WCP52/input_frontend/pcb/renders/render_2l_small.png

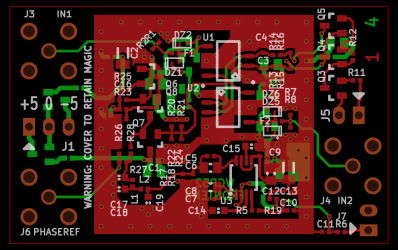
pcb/renders/render_2l_small.png
