WCP52/input_frontend/pcb/renders/render_lyr1_small.png

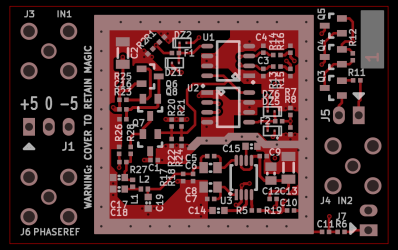
pcb/renders/render_lyr1_small.png
