WCP52/input_frontend/README.md

input_frontend
==============

Gain/Phase analyzer input frontend
