WCP52/input_frontend/pcb/renders/page_Buffer_Filter-Buffer_Filter.png

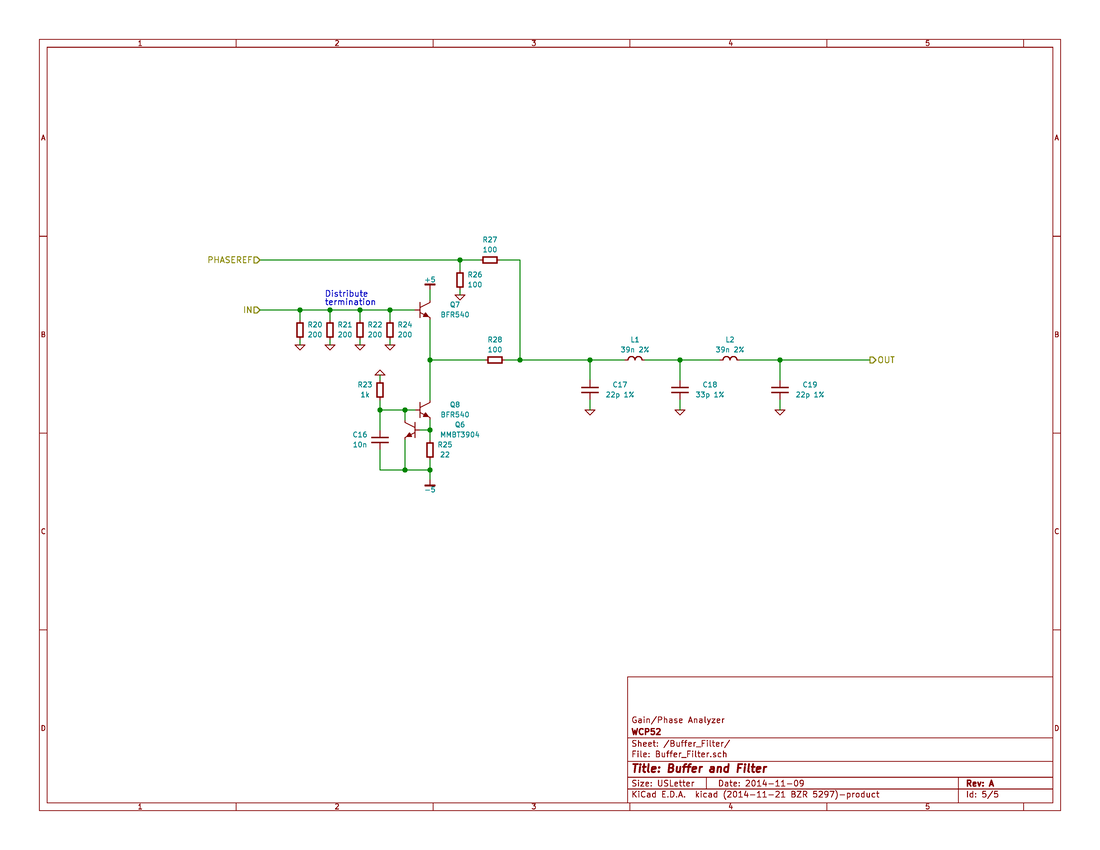
pcb/renders/page_Buffer_Filter-Buffer_Filter.png
