WCP52/input_frontend/pcb/renders/page_Detector-Detector.png

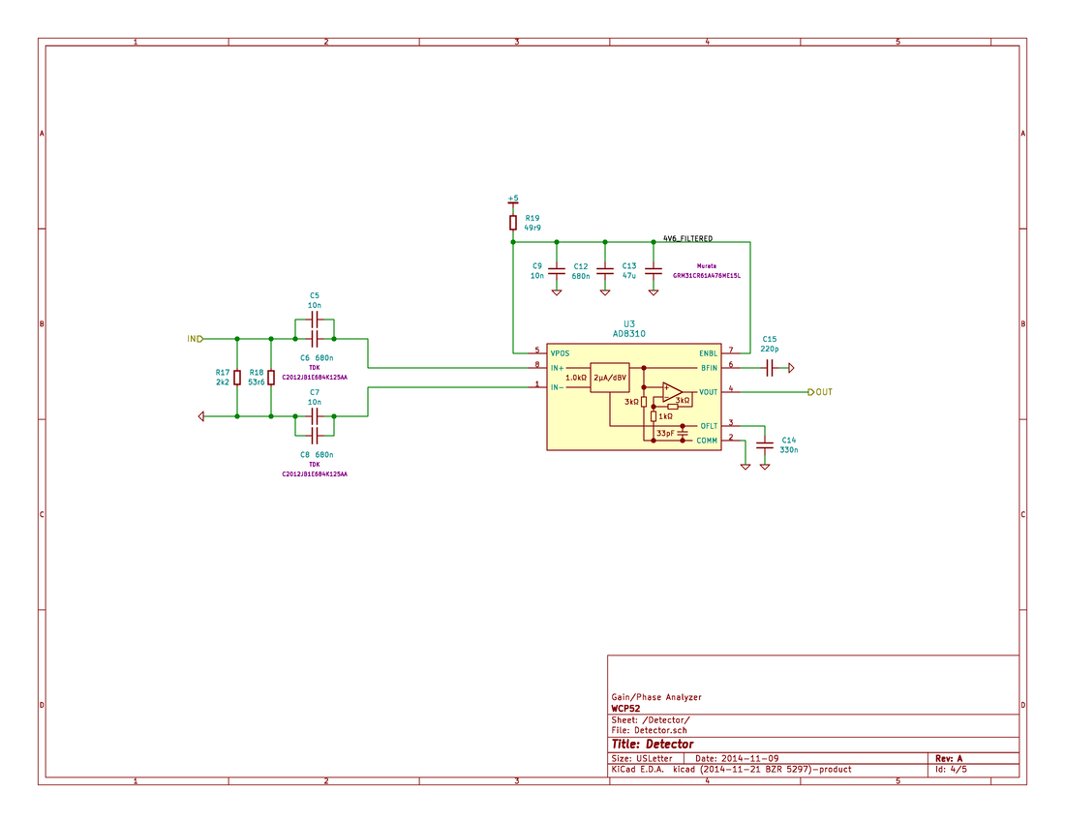
pcb/renders/page_Detector-Detector.png
