WCP52/input_frontend/pcb/renders/page_Protection-Protection.png

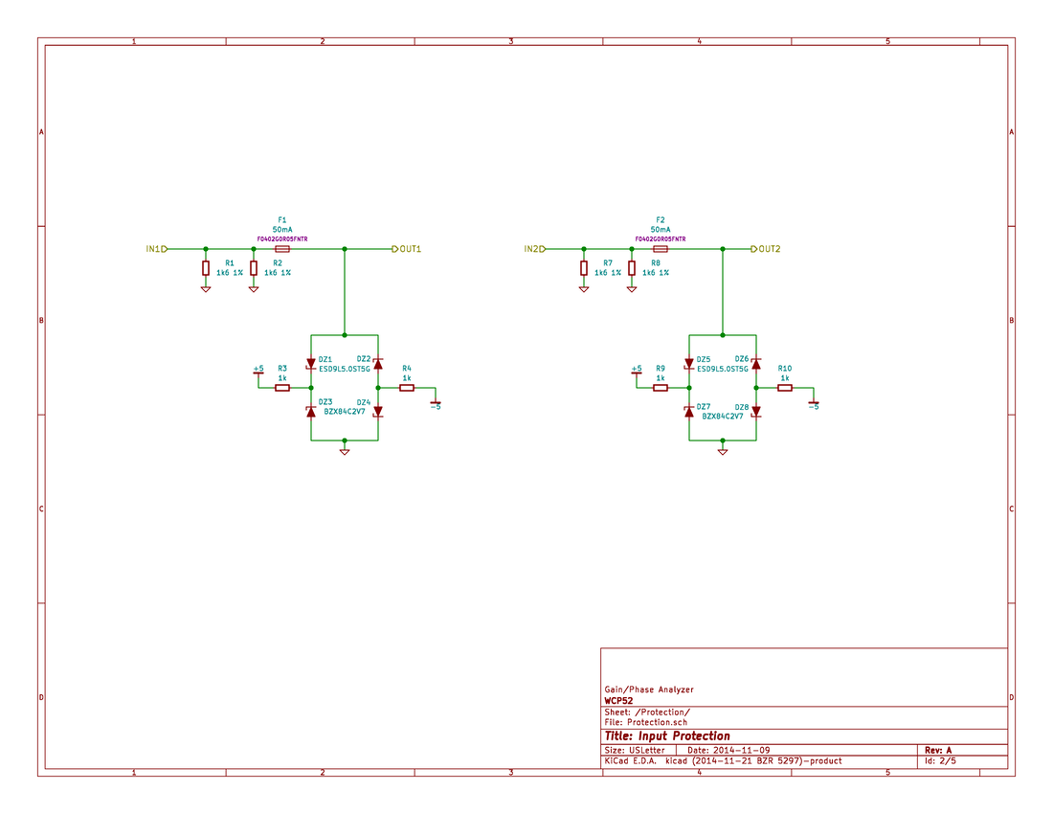
pcb/renders/page_Protection-Protection.png
