WCP52/input_frontend/pcb/renders/page_Switching-Switching.png

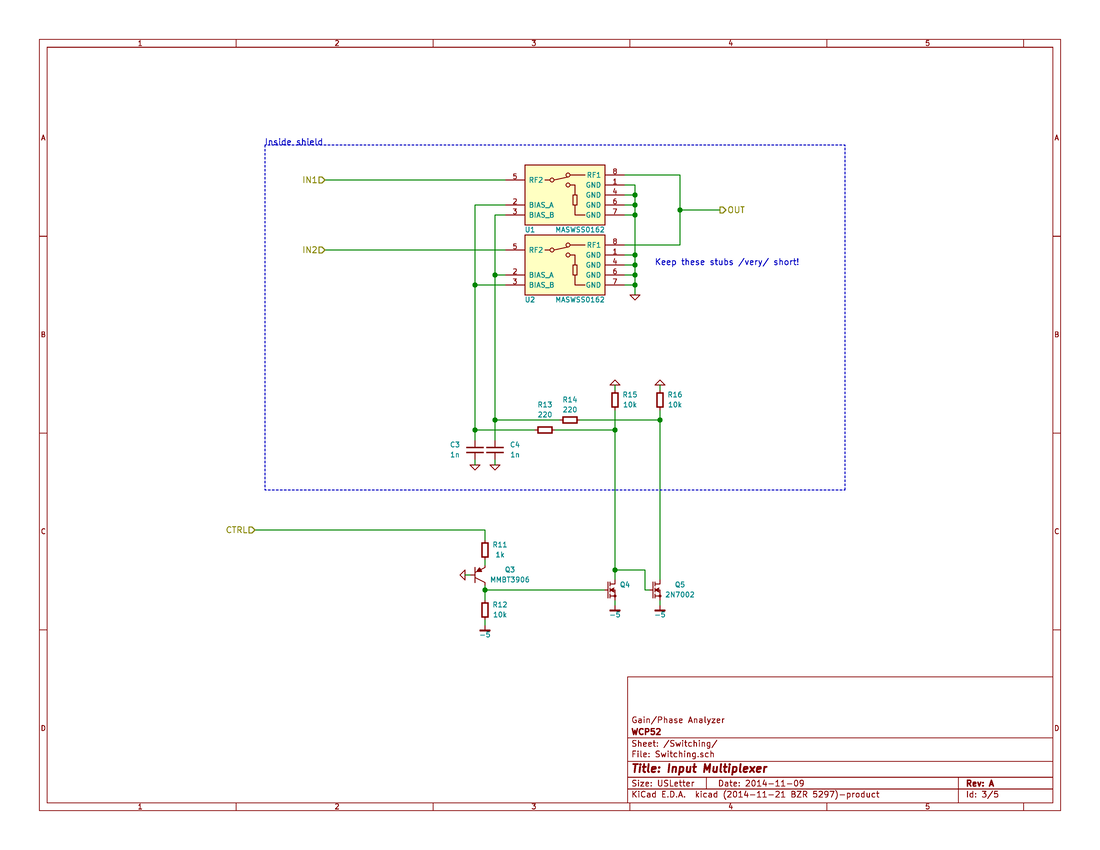
pcb/renders/page_Switching-Switching.png
