WCP52/input_frontend/pcb/renders/page_wcp52-input.png

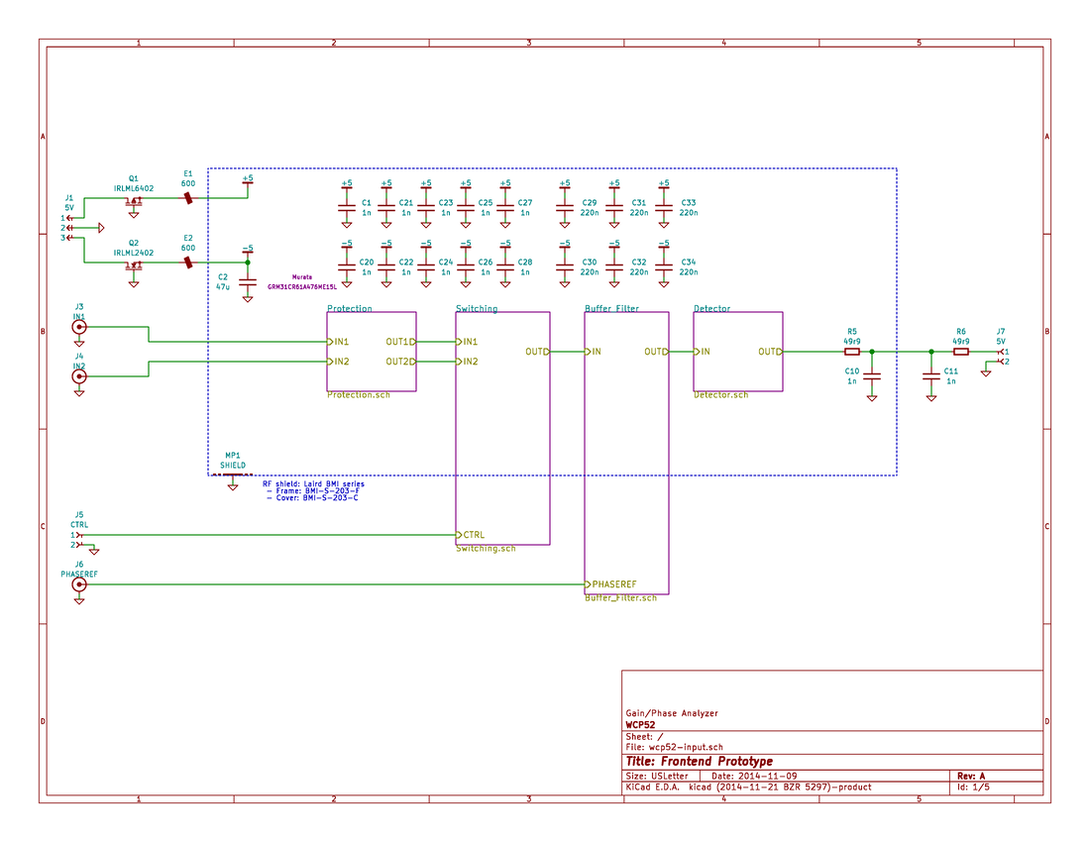
pcb/renders/page_wcp52-input.png
