WCP52/input_frontend/pcb/renders/render_3d_small.png

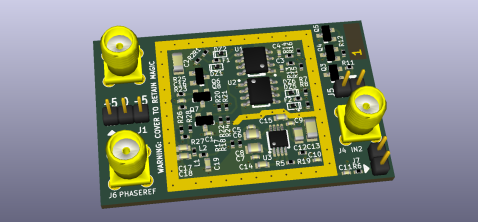
pcb/renders/render_3d_small.png
