WCP52/input_frontend/pcb/renders/render_lyr2.png

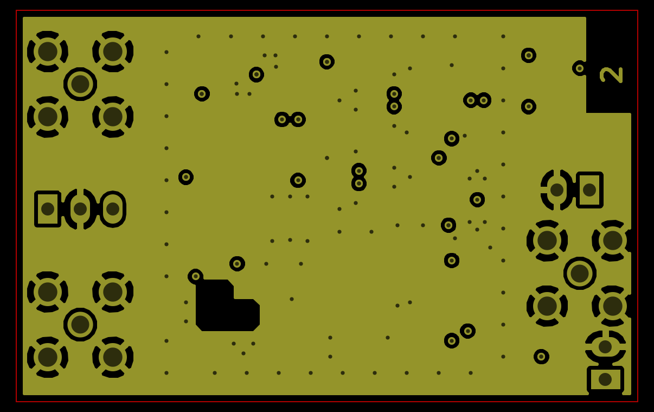
pcb/renders/render_lyr2.png
