WCP52/input_frontend/pcb/renders/render_lyr3.png

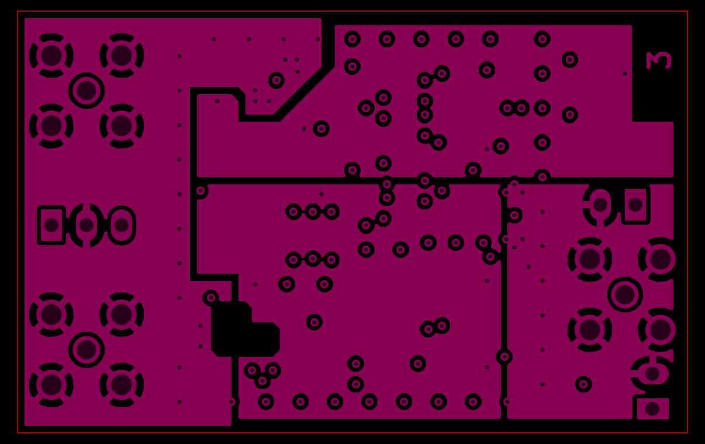
pcb/renders/render_lyr3.png
