WCP52/input_frontend/pcb/renders/render_lyr4.png

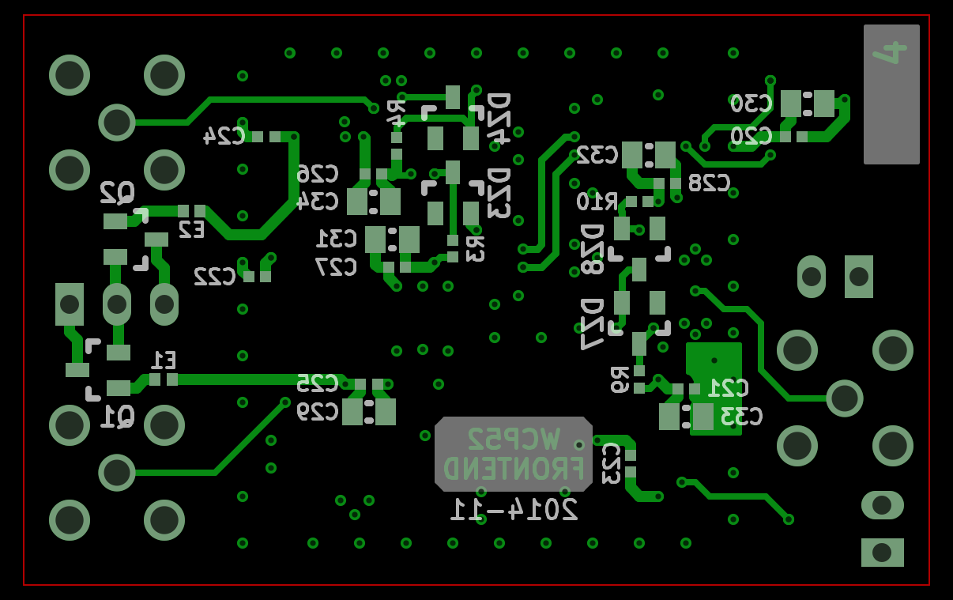
pcb/renders/render_lyr4.png
