WCP52/input_frontend/pcb/renders/schematic_small.png

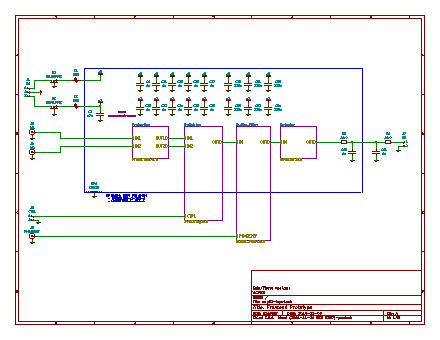
pcb/renders/schematic_small.png
