WCP52/input_frontend/pcb/wcp52-input.kicad_pcb

## KiCad design pcb/wcp52-input.kicad_pcb (2014-11-14)

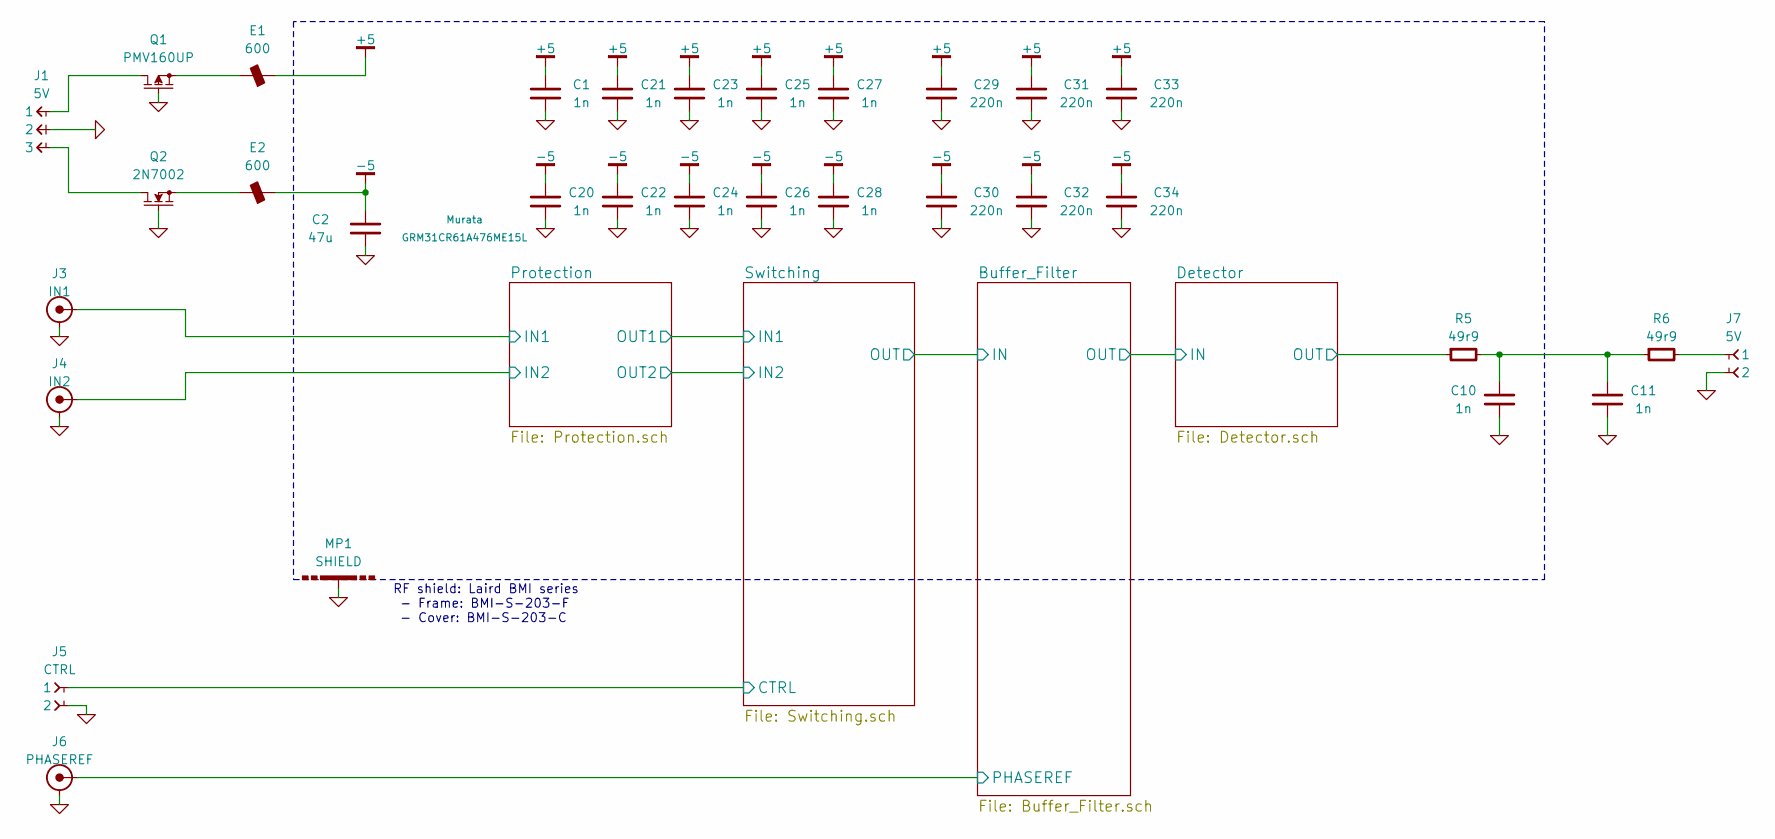
[picture p18: schematic wcp52-input.sch, Frontend Prototype]

Parts:
C1, C10, C11, C20, C21, C22, C23, C24, C25, C26, C27, C28: 1n; CAPC1005X55
C2: 47u; CAPC3216X70
C29, C30, C31, C32, C33, C34: 220n; CAPC2012X70
E1, E2: 600; INDC1005X60
J1: 5V; CONN_3-SIL
J3: IN1; CONN-2_CONSMA001
J4: IN2; CONN-2_CONSMA001
J5: CTRL; CONN_2-SIL
J6: PHASEREF; CONN-2_CONSMA001
J7: 5V; CONN_2-SIL
MP1: SHIELD
Q1: PMV160UP; SOT-23
Q2: 2N7002; SOT-23
R5, R6: 49r9; RESC1005X40

Connections:
+5: C1.1, C21.1, C23.1, C25.1, C27.1, C29.1, C31.1, C33.1, E1.2; also elsewhere on the board
-5: C2.1, C20.1, C22.1, C24.1, C26.1, C28.1, C30.1, C32.1, C34.1, E2.2; also elsewhere on the board
/Buffer_Filter/PHASEREF: J6.1; also elsewhere on the board
/Detector/OUT: R5.1; also elsewhere on the board
/Protection/IN1: J3.1; also elsewhere on the board
/Protection/IN2: J4.1; also elsewhere on the board
/Switching/CTRL: J5.1; also elsewhere on the board
GND: C1.2, C2.2, C10.2, C11.2, C20.2, C21.2, C22.2, C23.2, C24.2, C25.2, C26.2, C27.2, C28.2, C29.2, C30.2, C31.2, C32.2, C33.2, C34.2, J1.2, J3.2, J4.2, J5.2, J6.2, J7.2, MP1.1, Q1.1, Q2.1; also elsewhere on the board
unnamed: C10.1, C11.1, R5.2, R6.1
unnamed: E1.1, Q1.2
unnamed: E2.1, Q2.2
unnamed: J1.1, Q1.3
unnamed: J1.3, Q2.3
unnamed: J7.1, R6.2

Notes on the sheet:
RF shield: Laird BMI series - Frame: BMI-S-203-F - Cover: BMI-S-203-C

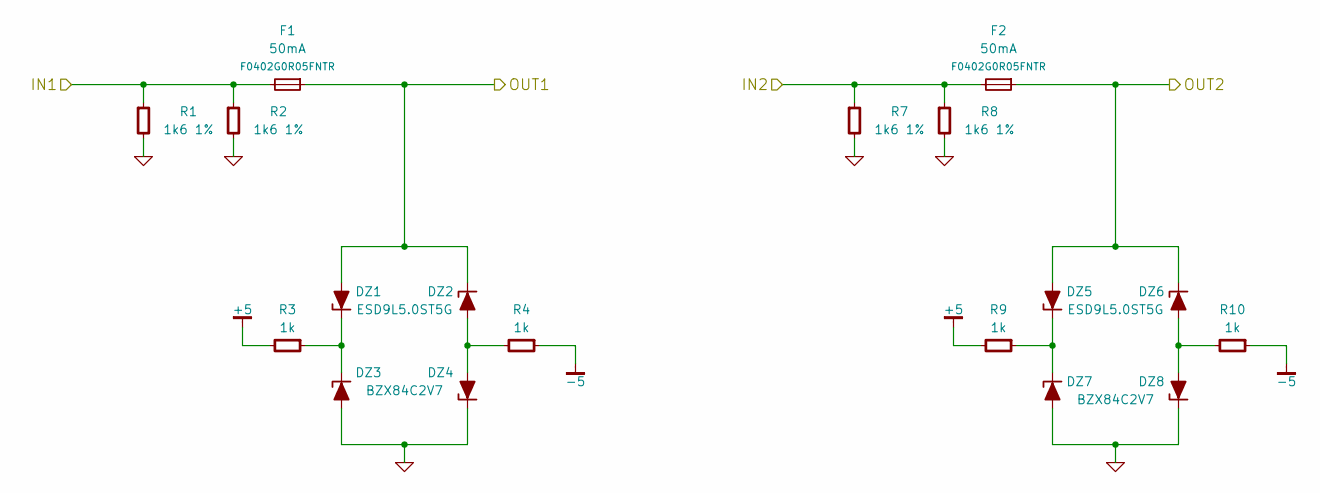
[picture p19: schematic Protection.sch, Input Protection]

Parts:
DZ1, DZ2, DZ5, DZ6: ESD9L5.0ST5G; SOD-923
DZ3, DZ4, DZ7, DZ8: BZX84C2V7; SOT-23
F1, F2: 50mA; RESC1005X40
R1, R2, R7, R8: 1k6 1%; RESC1005X40
R3, R4, R9, R10: 1k; RESC1005X40

Connections:
+5: R3.2, R9.2; also elsewhere on the board
-5: R4.1, R10.1; also elsewhere on the board
/Protection/IN1: F1.2, R1.1, R2.1; also elsewhere on the board
/Protection/IN2: F2.2, R7.1, R8.1; also elsewhere on the board
/Switching/IN1: DZ1.2, DZ2.1, F1.1; also elsewhere on the board
/Switching/IN2: DZ5.2, DZ6.1, F2.1; also elsewhere on the board
GND: DZ3.1, DZ4.3, DZ7.1, DZ8.3, R1.2, R2.2, R7.2, R8.2; also elsewhere on the board
unnamed: DZ1.1, DZ3.3, R3.1
unnamed: DZ2.2, DZ4.1, R4.2
unnamed: DZ5.1, DZ7.3, R9.1
unnamed: DZ6.2, DZ8.1, R10.2

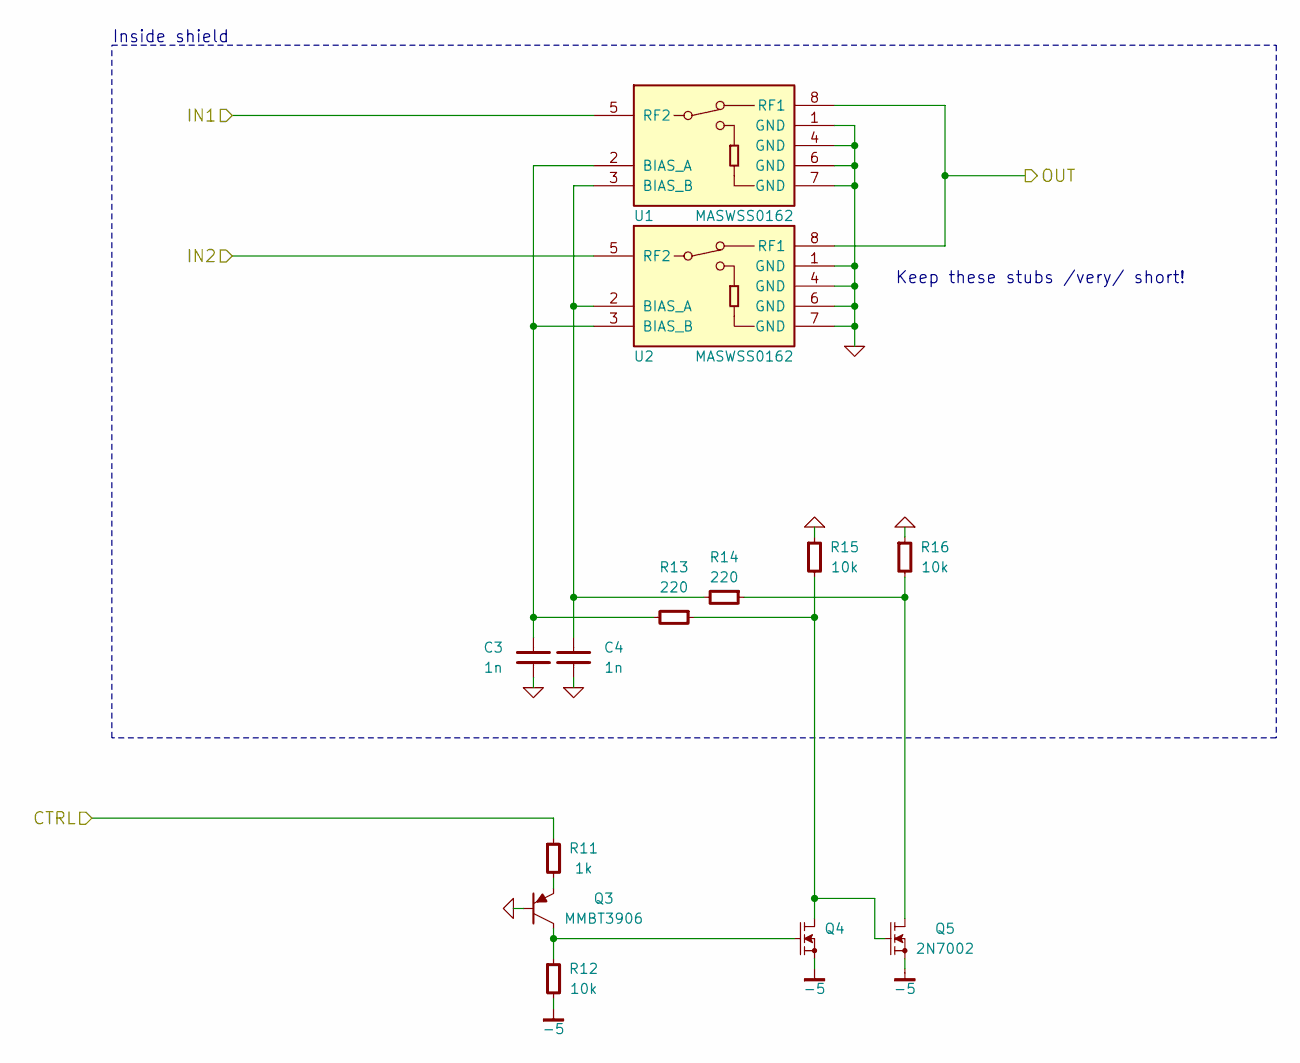
[picture p20: schematic Switching.sch, Input Multiplexer]

Parts:
C3, C4: 1n; CAPC1005X55
Q3: MMBT3906; SOT-23
Q4, Q5: 2N7002; SOT-23
R11: 1k; RESC1005X40
R12, R15, R16: 10k; RESC1005X40
R13, R14: 220; RESC1005X40
U1, U2: MASWSS0162; SOIC127P600X175-8

Connections:
-5: Q4.2, Q5.2, R12.2; also elsewhere on the board
/Buffer_Filter/IN: U1.8 (RF1), U2.8 (RF1); also elsewhere on the board
/Switching/CTRL: R11.1; also elsewhere on the board
/Switching/IN1: U1.5 (RF2); also elsewhere on the board
/Switching/IN2: U2.5 (RF2); also elsewhere on the board
GND: C3.2, C4.2, Q3.1, R15.1, R16.1, U1.1 (GND), U1.4 (GND), U1.6 (GND), U1.7 (GND), U2.1 (GND), U2.4 (GND), U2.6 (GND), U2.7 (GND); also elsewhere on the board
unnamed: C3.1, R13.2, U1.2 (BIAS_A), U2.3 (BIAS_B)
unnamed: C4.1, R14.2, U1.3 (BIAS_B), U2.2 (BIAS_A)
unnamed: Q3.2, R11.2
unnamed: Q3.3, Q4.1, R12.1
unnamed: Q4.3, Q5.1, R13.1, R15.2
unnamed: Q5.3, R14.1, R16.2

Notes on the sheet:
Keep these stubs /very/ short!
Inside shield

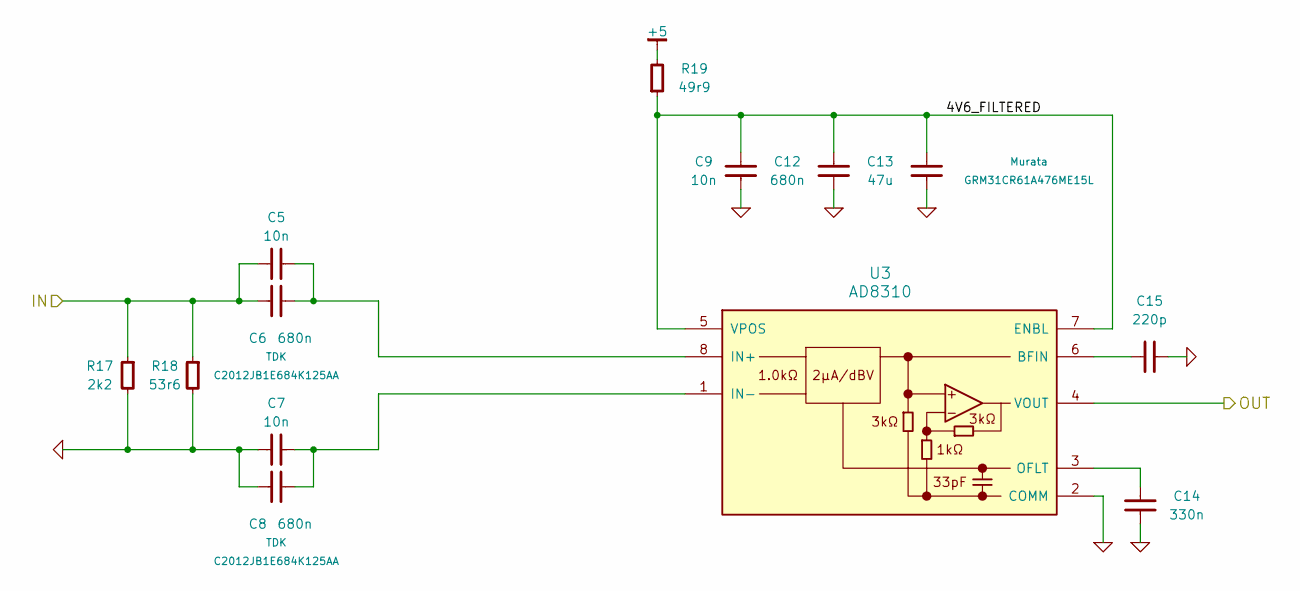
[picture p21: schematic Detector.sch]

Parts:
C5, C7, C9: 10n; CAPC1005X55
C6, C8, C12: 680n; CAPC2012X70
C13: 47u; CAPC3216X70
C14: 330n; CAPC1608X55
C15: 220p; CAPC1608X55
R17: 2k2; RESC1005X40
R18: 53r6; RESC1005X40
R19: 49r9; RESC1005X40
U3: AD8310; SOP65P490X109-8

Connections:
+5: R19.2; also elsewhere on the board
/Detector/4V6_FILTERED: C9.1, C12.2, C13.1, R19.1, U3.5 (VPOS), U3.7 (ENBL)
/Detector/IN: C5.1, C6.2, R17.1, R18.1; also elsewhere on the board
/Detector/OUT: U3.4 (VOUT); also elsewhere on the board
GND: C7.1, C8.2, C9.2, C12.1, C13.2, C14.2, C15.2, R17.2, R18.2, U3.2 (COMM); also elsewhere on the board
unnamed: C5.2, C6.1, U3.8 (IN+)
unnamed: C7.2, C8.1, U3.1 (IN-)
unnamed: C14.1, U3.3 (OFLT)
unnamed: C15.1, U3.6 (BFIN)

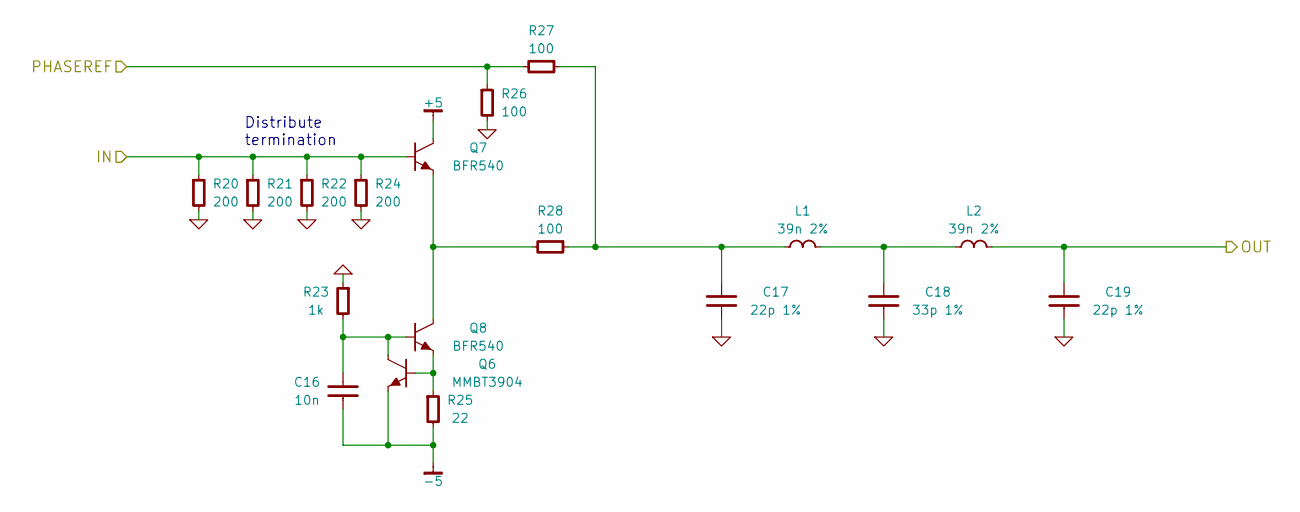
[picture p22: schematic Buffer_Filter.sch, Buffer and Filter]

Parts:
C16: 10n; CAPC1005X55
C17, C19: 22p 1%; CAPC1608X55
C18: 33p 1%; CAPC1608X55
L1, L2: 39n 2%; INDC1005X60
Q6: MMBT3904; SOT-23
Q7, Q8: BFR540; SOT-23
R20, R21, R22, R24: 200; RESC1005X40
R23: 1k; RESC1005X40
R25: 22; RESC1005X40
R26, R27, R28: 100; RESC1005X40

Connections:
+5: Q7.3; also elsewhere on the board
-5: C16.2, Q6.2, R25.2; also elsewhere on the board
/Buffer_Filter/IN: Q7.1, R20.1, R21.1, R22.1, R24.1; also elsewhere on the board
/Buffer_Filter/PHASEREF: R26.1, R27.2; also elsewhere on the board
/Detector/IN: C19.1, L2.1; also elsewhere on the board
GND: C17.2, C18.2, C19.2, R20.2, R21.2, R22.2, R23.1, R24.2, R26.2; also elsewhere on the board
unnamed: C16.1, Q6.3, Q8.1, R23.2
unnamed: C17.1, L1.2, R27.1, R28.1
unnamed: C18.1, L1.1, L2.2
unnamed: Q6.1, Q8.2, R25.1
unnamed: Q7.2, Q8.3, R28.2

Notes on the sheet:
Distribute termination

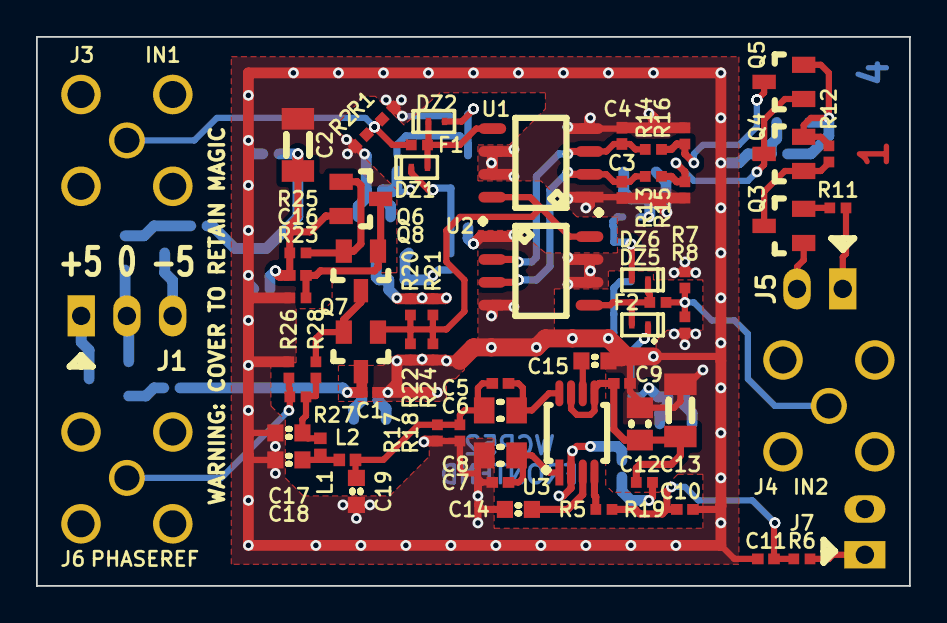
[picture p23: board wcp52-input.kicad_pcb from above]

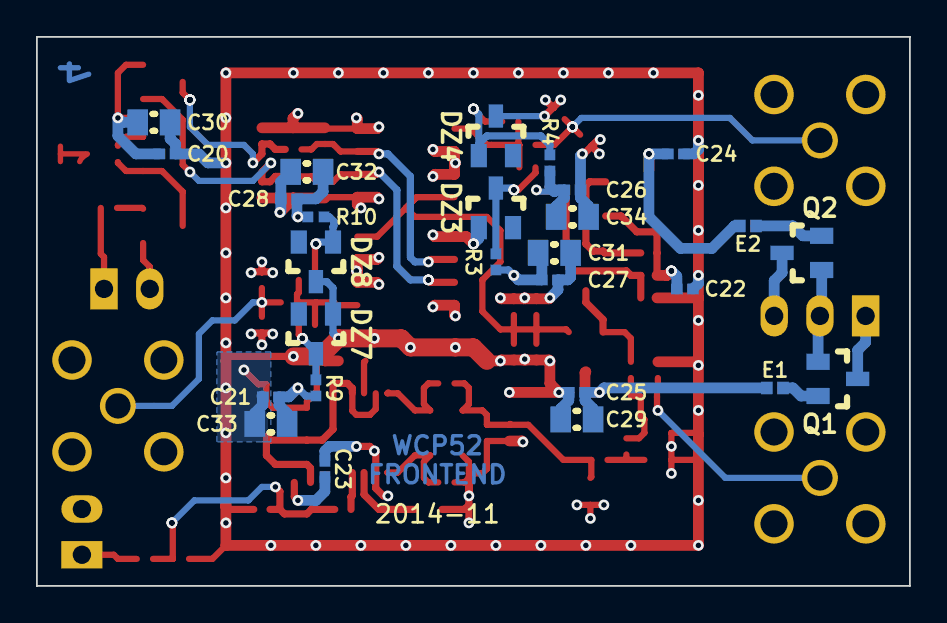
[picture p24: board wcp52-input.kicad_pcb from below]

Board: 4 copper layers, 48.5 x 30.5 mm, 93 parts (27 on the bottom side), 38 nets.
