WCP52/input_frontend/(commit log)

2014-11-09 Checked in schematic files from other repos
    [Buffer_Filter.sch, Detector.sch, Protection.sch, Switching.sch, wcp52-detector.sch]
2014-11-09 Renamed 'detector' project to 'input frontend'
    [Buffer_Filter.sch, Detector.sch, Protection.sch, Switching.sch, wcp52-input.sch]
2014-11-09 Replaced clamping diode placeholders
    [Buffer_Filter.sch, Detector.sch, Protection.sch, Switching.sch, wcp52-input.sch]
2014-11-09 Configured PCB
    [wcp52-input.kicad_pcb]
2014-11-09 Added shield pad
    [wcp52-input.kicad_pcb]
2014-11-09 Specified part for C14
    U# (AD8310) offset filter capacitor
    [Buffer_Filter.sch, Detector.sch, Protection.sch, Switching.sch, wcp52-input.sch]
2014-11-09 Associated parts with footprints
    [Buffer_Filter.sch, Detector.sch, Protection.sch, Switching.sch, wcp52-input.sch]
2014-11-09 Routed PCB
    [Buffer_Filter.sch, Detector.sch, Protection.sch, Switching.sch, wcp52-input.kicad_pcb, wcp52-input.sch]
2014-11-09 Rearranged - smaller PCB
    [wcp52-input.kicad_pcb]
2014-11-10 PCB tweaks
    [wcp52-input.kicad_pcb]
2014-11-11 Corrected postprocessing scripts
    [wcp52-input.GBL, wcp52-input.GBO, wcp52-input.GBS, wcp52-input.GKO, wcp52-input.GTL, wcp52-input.GTO, wcp52-input.GTS, wcp52-input.XLN]
2014-11-11 Corrected internal planes
    Controlled-impedance trace on back of board to J4 must be backed by
    ground, not +5
    [wcp52-input.kicad_pcb]
2014-11-11 Added more decoupling
    [Buffer_Filter.sch, Detector.sch, Protection.sch, Switching.sch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]
2014-11-11 Corrected schematic page sizes
    [Buffer_Filter.sch, Detector.sch]
2014-11-11 Adjusted filter for proper Chebyshev response
    [Buffer_Filter.sch]
2014-11-11 Removed ground under filter
    Minimize error from stray capacitance
    [wcp52-input.kicad_pcb]
2014-11-12 Rearranged to fit visible refdes
    [wcp52-input.GBL, wcp52-input.GBO, wcp52-input.GBS, wcp52-input.GKO, wcp52-input.GTL, wcp52-input.GTO, wcp52-input.GTS, wcp52-input.XLN]
2014-11-12 How'd the schematic revert back to the old one?
    *grumble*
2014-11-12 Added new schematic renders - will postprocess remotely
2014-11-14 Switched to PTH SMA connectors
    [wcp52-input.kicad_pcb, wcp52-input.sch]
2014-11-14 Minor silkscreen fixes
    [wcp52-input.GBL, wcp52-input.GBO, wcp52-input.GBS, wcp52-input.GKO, wcp52-input.GTL, wcp52-input.GTO, wcp52-input.GTS, wcp52-input.XLN]
2014-11-17 Updated MOSFET types
    [Buffer_Filter.sch, Detector.sch, Protection.sch, Switching.sch, wcp52-input.sch]
2014-11-29 Updated schematic renders
    [Buffer_Filter.sch, Detector.sch, Protection.sch, Switching.sch, wcp52-input.sch]
